HMSteve/HB-UNI-Sen-RainCounter/(threads)

Thread 1 (2022-06-23):

Wie lässt sich die Menge pro Wippenschlag errechnet?

josefglatz, 2022-06-23:
Mich würde das interessieren, da ich einen Regenmesser aus dem Hause China ergattern konnte.

mit lieben Dank im Voraus

HMSteve, 2022-06-23:
Eine bekannte Menge Wasser (einige 100 ml) sehr langsam in den Regenmesser gießen und die Wippenschlaege zählen. Per Dreisatz erhält man Regenmenge pro Wippenschlag. Die Menge in l geteilt durch die Fläche der Öffnung des Regenmessers in qm ergibt mm Regen pro Wippenschlag.

josefglatz, 2022-06-23:
Herzlichsten Dank!!!!!!

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

Closed 2022-06-23.

Thread 2 (2023-07-13):

can't teach top the ccu

elmarfaber, 2023-07-13:
I try top teach top my ccu but it does't work

HMSteve, 2023-07-13:
Please describe your problem in sufficient detail. If the corrct version of the Addon is installed as per Readme and frequency calibrated correctly it should work fine.
